lusiyuan-github/lab_wanna/README.md

##### 本展台展示的是智能家居系统。

首先看到的是**门禁系统**，当识别正确卡时候，门打开，手机上可以了解是谁打开了门。

当识别错误时候，蜂鸣器发生警报，当识别错误次数过多，手机显示提醒信息。

当我们进入房间以后，我们第一步肯定是**开灯**，我们可以用手机端开灯，或者直接说一句“小爱同学，打开室内的灯”。

你可能也有些特殊喜好或环境渲染，直接说一句“小爱同学，将室内的灯调为蓝色”，直接营造一种忧郁气氛。

当然你也可以调节灯的亮度，比如直接说一句“小爱同学，将室内的灯亮度调为50”，合适的亮度能保护你的眼睛。

当你打开了灯坐好以后，你可能会想，怎么这么热？/怎么这么冷，那就是决定是你生病了还是该开空调的时候了。

直接说一句“小爱同学，查询**室内温度/湿度**”或者你直接读身旁的OLED上数值就可以知道当前室内温度了。

也许某天是个大晴天，你坐在家里觉得炎热万分，打开手机端，赶快调节一下窗帘，一定是外面阳光过于炎热了！

又或许你太懒了，懒到都不想用手机开**窗帘**，那你直接打开自动模式，窗帘会根据当前光亮自动开合。

这就是本智能家居的全部功能。

如果你不够富有，将新买来普通电视或者空调之类的家居，经过本程序和我的调试，你也能用语音或者手机将你的家居智能化。

这就是这个物联网时代的魅力，这也就是我完成此课题的初衷。

------



> 完成于2020.11.8
